MarvFPV/AccipiterF7/README.md

# Accipiter F7
A flight controller built for Rotorflight firmware and their F7A target. 
For more info go check out my [blog entry](https://mschnabel.com/2025/01/27/AccipiterF7/) on it!
