MarvFPV/AccipiterF7/Topplate/Bottomplate1-Bottomplate.step

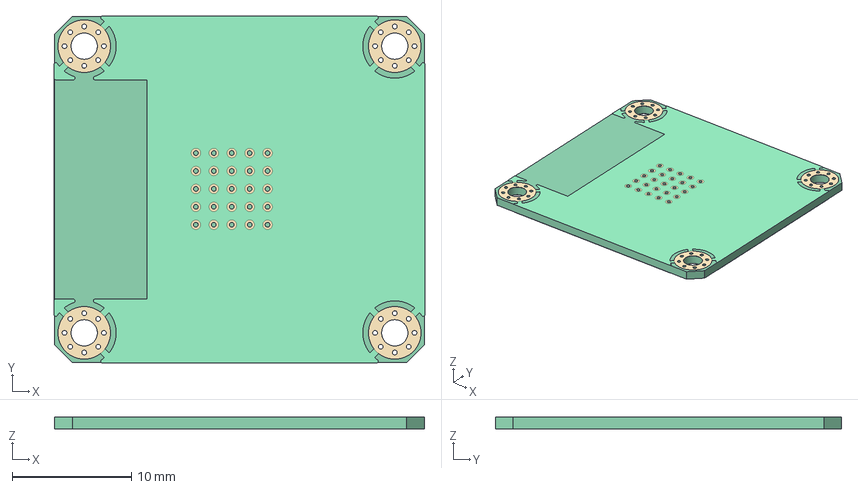
[picture p1: CAD file, 2023-10-14]
Topplate/Bottomplate1-Bottomplate.step
31.0 x 29.0 x 1.04 mm
Local_CS_69e
Pcb_69e
PCB_Sketch_69e
topPads_69e_cut
topZones_69e
botPads_69e
botZones_69e
