MarvFPV/AccipiterF7/Topplate/Topplate-Topplate.step

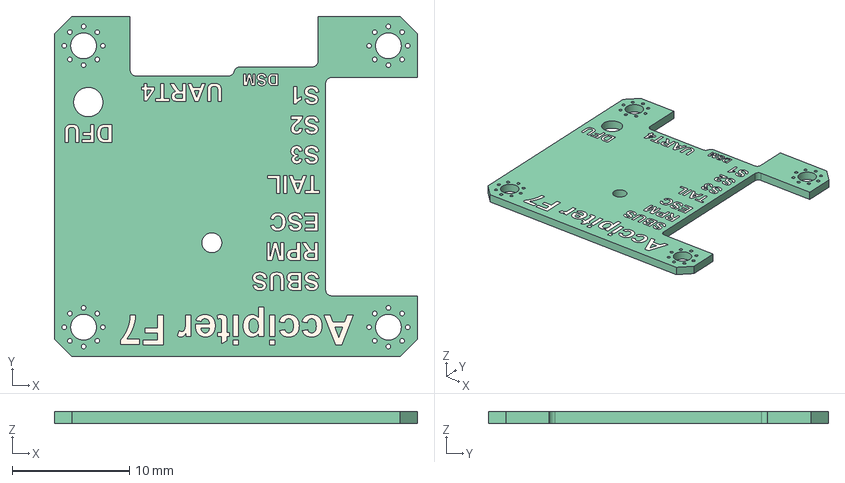
[picture p2: CAD file, 2023-10-14]
Topplate/Topplate-Topplate.step
31.0 x 29.0 x 1.07 mm
Local_CS_e7c5
Pcb_e7c5
PCB_Sketch_e7c5
topSilks_88ca
