MarvFPV/AccipiterF7/(list of files, cad)

Other CAD files:
Topplate/Topplate-F_Silkscreen.dxf
