MarvFPV/AccipiterF7/AccipiterF7.kicad_pcb

## KiCad design AccipiterF7.kicad_pcb (2025-01-27)

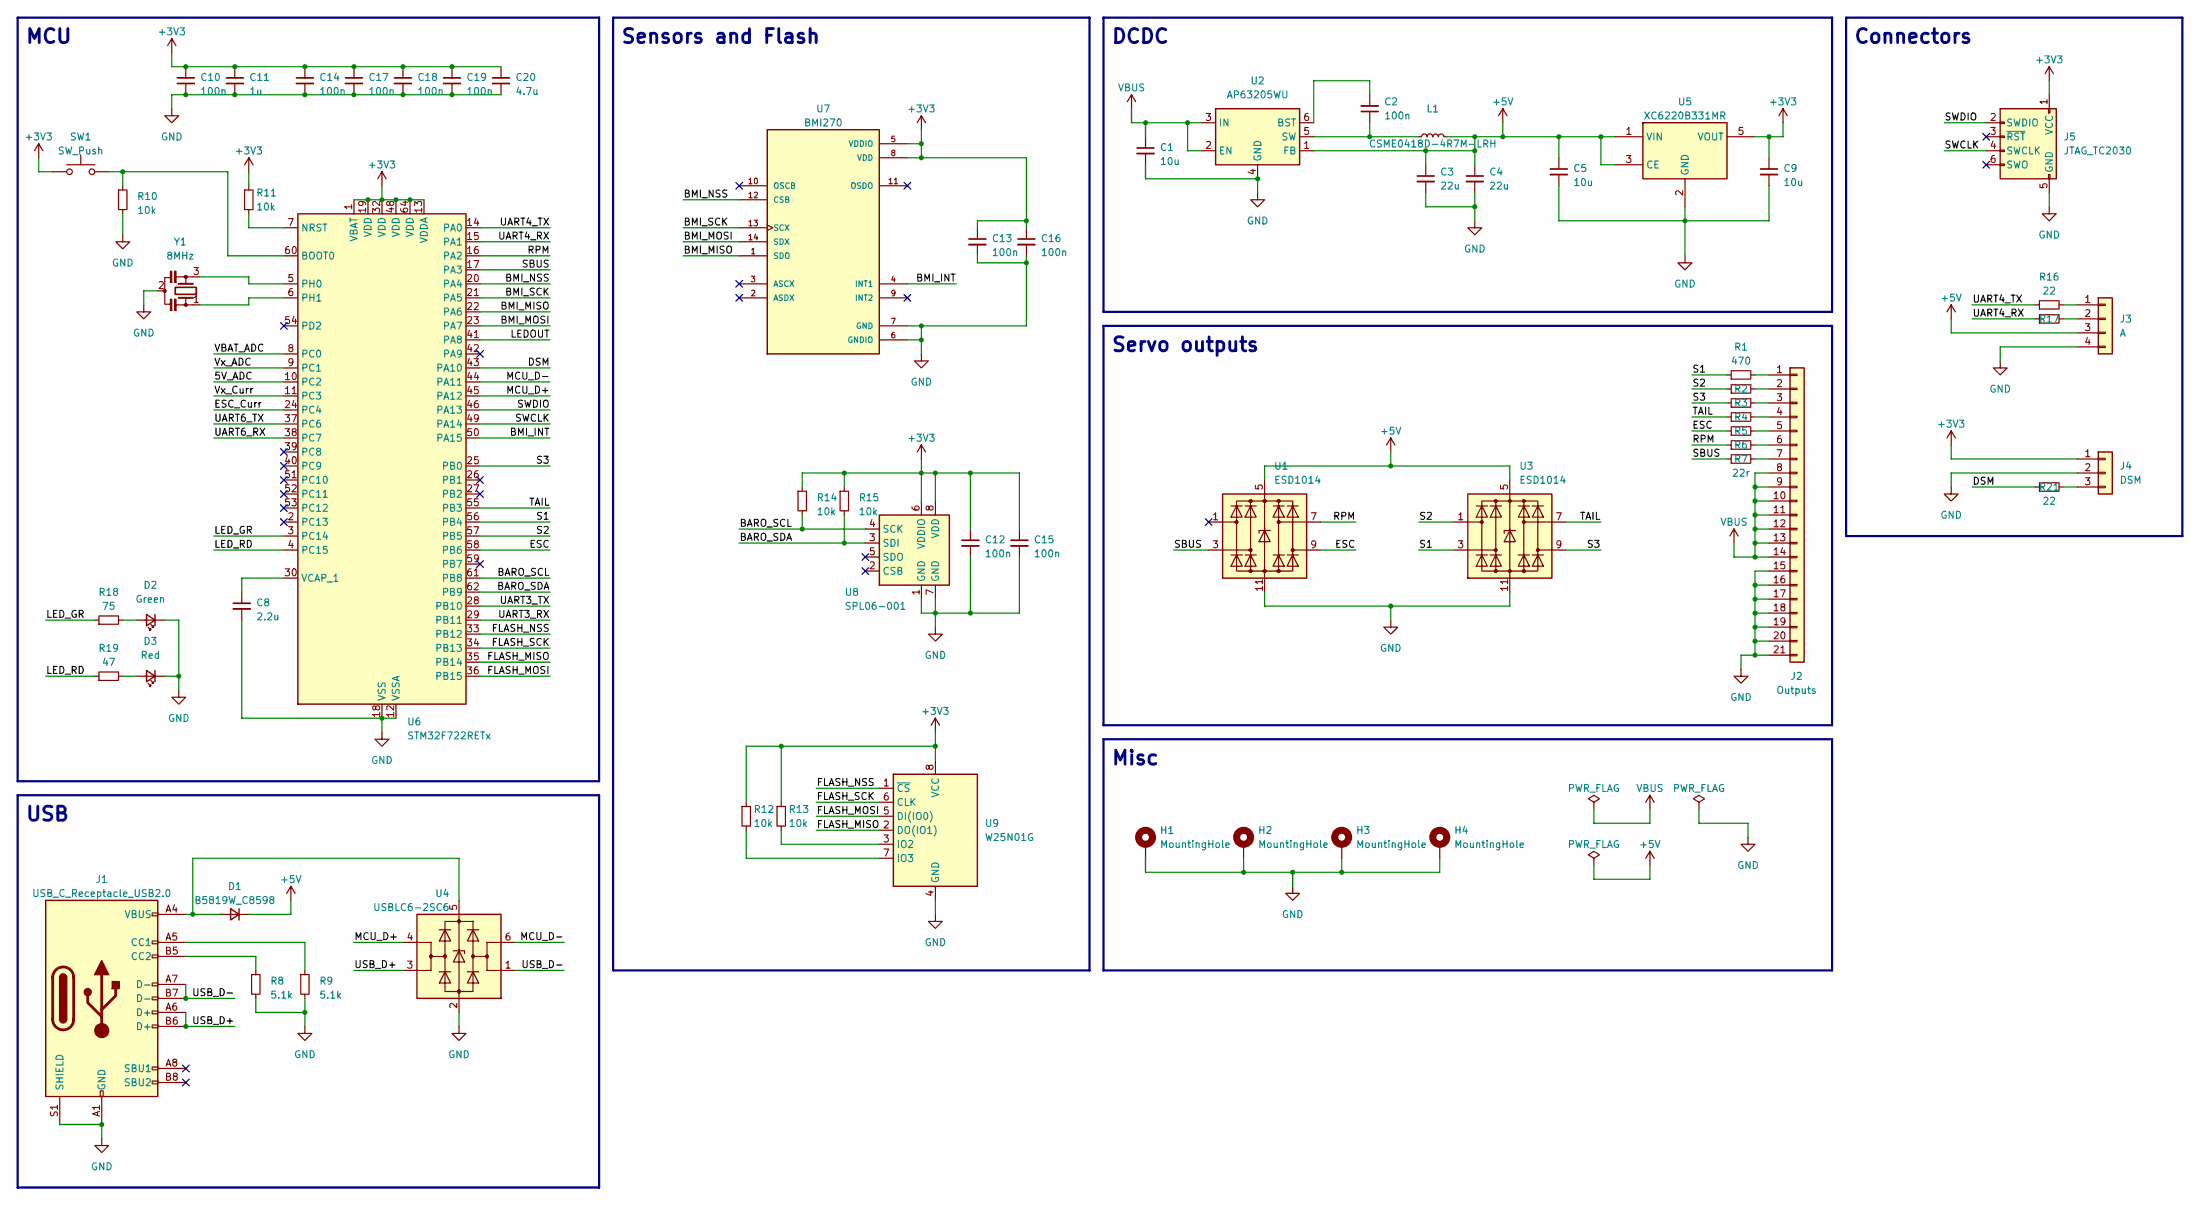
[picture p3: schematic AccipiterF7.kicad_sch]

Parts:
C1, C5, C9: 10u; C_0603_1608Metric
C2, C10, C12, C13, C14, C15, C16, C17, C18, C19: 100n; C_0402_1005Metric
C3, C4: 22u; C_0603_1608Metric
C8: 2.2u; C_0402_1005Metric
C11: 1u; C_0402_1005Metric
C20: 4.7u; C_0402_1005Metric
D1: B5819W_C8598; D_SOD-123
D2: Green; LED_0603_1608Metric
D3: Red; LED_0603_1608Metric
H1, H2, H3, H4: MountingHole; MountingHole_2.2mm_M2_Pad_Via
J1: USB_C_Receptacle_USB2.0; USB_C_Receptacle_HRO_TYPE-C-31-M-12
J2: Outputs; 7xServo_Vertical
J3: A; JST_GH_BM04B-GHS-TBT_1x04-1MP_P1.25mm_Vertical
J4: DSM; JST_ZH_B3B-ZR_1x03_P1.50mm_Vertical
J5: JTAG_TC2030; CON_TC2030_outlined
L1: CSME0418D-4R7M-LRH; L_Vishay_IFSC-1515AH_4x4x1.8mm
R1, R2, R3, R4, R5, R6: 470; R_0402_1005Metric
R7: 22r; R_0402_1005Metric
R8, R9: 5.1k; R_0402_1005Metric
R10, R11, R12, R13, R14, R15: 10k; R_0402_1005Metric
R16, R17, R21: 22; R_0402_1005Metric
R18: 75; R_0402_1005Metric
R19: 47; R_0402_1005Metric
SW1: SW_Push; SW_Push_SPST_NO_Alps_SKRK
U1, U3: ESD1014; DFN-10-1EP_2.6x2.6mm_P0.5mm_EP1.3x2.2mm
U2: AP63205WU; TSOT-23-6
U4: USBLC6-2SC6; SOT-23-6
U5: XC6220B331MR; SOT-23-5
U6: STM32F722RETx; LQFP-64_10x10mm_P0.5mm
U7: BMI270; XDCR_BMI270
U8: SPL06-001; Bosch_LGA-8_2x2.5mm_P0.65mm_ClockwisePinNumbering
U9: W25N01G; WSON-8-1EP_8x6mm_P1.27mm_EP3.4x4.3mm
Y1: 8MHz; Resonator_SMD_Murata_CSTxExxV-3Pin_3.0x1.1mm

Connections:
+3V3: C9.1, C10.1, C11.1, C12.1, C13.1, C14.1, C15.1, C16.1, C17.1, C18.1, C19.1, C20.1, J4.1, J5.1 (VCC), R11.1, R12.1, R13.1, R14.1, R15.1, SW1.1, U5.5 (VOUT), U6.1 (VBAT), U6.13 (VDDA), U6.19 (VDD), U6.32 (VDD), U6.48 (VDD), U6.64 (VDD), U7.5 (VDDIO), U7.8 (VDD), U8.6 (VDDIO), U8.8 (VDD), U9.8 (VCC)
+5V: C3.1, C4.1, C5.1, D1.1 (K), J3.3, L1.2, U1.5 (VBUS), U2.1 (FB), U3.5 (VBUS), U5.1 (VIN), U5.3 (CE)
/5V_ADC: U6.10 (PC2)
/BARO_SCL: R14.2, U6.61 (PB8), U8.4 (SCK)
/BARO_SDA: R15.2, U6.62 (PB9), U8.3 (SDI)
/BMI_INT: U6.50 (PA15), U7.4 (INT1)
/BMI_MISO: U6.22 (PA6), U7.1 (SDO)
/BMI_MOSI: U6.23 (PA7), U7.14 (SDX)
/BMI_NSS: U6.20 (PA4), U7.12 (CSB)
/BMI_SCK: U6.21 (PA5), U7.13 (SCX)
/DSM: R21.1, U6.43 (PA10)
/ESC: R5.1, U1.9 (I/O4), U6.58 (PB6)
/ESC_Curr: U6.24 (PC4)
/FLASH_MISO: U6.35 (PB14), U9.2 (DO(IO1))
/FLASH_MOSI: U6.36 (PB15), U9.5 (DI(IO0))
/FLASH_NSS: U6.33 (PB12), U9.1 (~CS)
/FLASH_SCK: U6.34 (PB13), U9.6 (CLK)
/LEDOUT: U6.41 (PA8)
/LED_GR: R18.1, U6.3 (PC14)
/LED_RD: R19.1, U6.4 (PC15)
/MCU_D+: U4.4 (I/O2), U6.45 (PA12)
/MCU_D-: U4.6 (I/O1), U6.44 (PA11)
/RPM: R6.1, U1.7 (I/O3), U6.16 (PA2)
/S1: R1.1, U3.3 (I/O2), U6.56 (PB4)
/S2: R2.1, U3.1 (I/O1), U6.57 (PB5)
/S3: R3.1, U3.9 (I/O4), U6.25 (PB0)
/SBUS: R7.1, U1.3 (I/O2), U6.17 (PA3)
/SWCLK: J5.4 (SWCLK), U6.49 (PA14)
/SWDIO: J5.2 (SWDIO), U6.46 (PA13)
/TAIL: R4.1, U3.7 (I/O3), U6.55 (PB3)
/UART3_RX: U6.29 (PB11)
/UART3_TX: U6.28 (PB10)
/UART4_RX: R17.1, U6.15 (PA1)
/UART4_TX: R16.1, U6.14 (PA0)
/UART6_RX: U6.38 (PC7)
/UART6_TX: U6.37 (PC6)
/USB_D+: J1.A6 (D+), J1.B6 (D+), U4.3 (I/O2)
/USB_D-: J1.A7 (D-), J1.B7 (D-), U4.1 (I/O1)
/VBAT_ADC: U6.8 (PC0)
/Vx_ADC: U6.9 (PC1)
/Vx_Curr: U6.11 (PC3)
GND: C1.2, C3.2, C4.2, C5.2, C8.2, C9.2, C10.2, C11.2, C12.2, C13.2, C14.2, C15.2, C16.2, C17.2, C18.2, C19.2, C20.2, D2.1 (K), D3.1 (K), H1.1, H2.1, H3.1, H4.1, J1.A1 (GND), J1.A12 (GND), J1.B1 (GND), J1.B12 (GND), J1.S1 (SHIELD), J2.15, J2.16, J2.17, J2.18, J2.19, J2.20, J2.21, J3.4, J4.2, J5.5 (GND), R8.2, R9.2, R10.2, U1.11 (GND), U2.4 (GND), U3.11 (GND), U4.2 (GND), U5.2 (GND), U6.12 (VSSA), U6.18 (VSS), U6.31 (VSS), U6.47 (VSS), U6.63 (VSS), U7.6 (GNDIO), U7.7 (GND), U8.1 (GND), U8.7 (GND), U9.4 (GND), Y1.2
unnamed: D1.2 (A), J1.A4 (VBUS), J1.A9 (VBUS), J1.B4 (VBUS), J1.B9 (VBUS), U4.5 (VBUS)
unnamed: D2.2 (A), R18.2
unnamed: D3.2 (A), R19.2
unnamed: J1.A5 (CC1), R9.1
unnamed: J1.B5 (CC2), R8.1
unnamed: J2.1, R1.2
unnamed: J2.2, R2.2
unnamed: J2.3, R3.2
unnamed: J2.4, R4.2
unnamed: J2.5, R5.2
unnamed: J2.6, R6.2
unnamed: J2.7, R7.2
unnamed: J3.1, R16.2
unnamed: J3.2, R17.2
unnamed: J4.3, R21.2
unnamed: C2.2, U2.6 (BST)
unnamed: C2.1, L1.1, U2.5 (SW)
unnamed: R10.1, SW1.2, U6.60 (BOOT0)
unnamed: R11.2, U6.7 (NRST)
unnamed: U6.5 (PH0), Y1.3
unnamed: U6.6 (PH1), Y1.1
unnamed: C8.1, U6.30 (VCAP_1)
unnamed: R13.2, U9.3 (IO2)
unnamed: R12.2, U9.7 (IO3)
VBUS: C1.1, J2.8, J2.9, J2.10, J2.11, J2.12, J2.13, J2.14, U2.2 (EN), U2.3 (IN)

Notes on the sheet:
USB
MCU
Connectors
Misc
Servo outputs
Sensors and Flash
DCDC

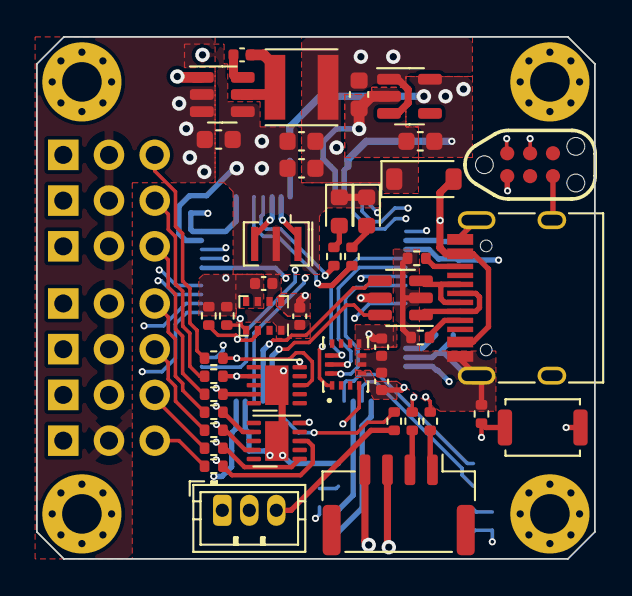
[picture p4: board AccipiterF7.kicad_pcb from above]

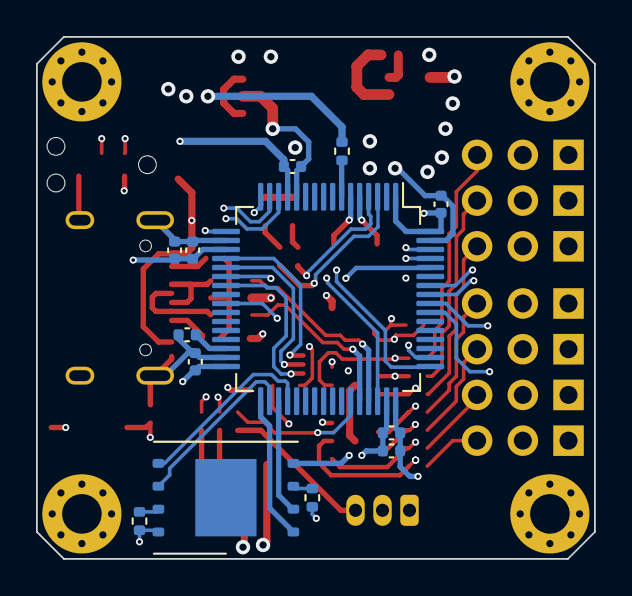
[picture p5: board AccipiterF7.kicad_pcb from below]

Board: 6 copper layers, 31.0 x 29.0 mm, 62 parts (13 on the bottom side), 57 nets.
