MarvFPV/AccipiterF7/(commit log)

2025-01-27 schematic visual updates
    [RotorflightF7.kicad_pcb, RotorflightF7.kicad_sch]
2025-01-27 adding cad, renaming, cleaning up
    [AccipiterF7.kicad_pcb, AccipiterF7.kicad_sch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]
2025-01-27 more cleanup
    [Bottomplate.dxf, Topplate.dxf]
